Abdullah-Atif/gsm-gps-tracker/esp32_devkit/pcb/drc_report.txt

** Drc report for /mnt/attach/outputs/gsm_tracking/pcb/gsm_tracker.kicad_pcb **
** Created on 2026-10-05 23:04:57 **

** Found 51 DRC violations **
[silk_overlap]: Silkscreen overlap
    Rule: board setup constraints silk; Severity: warning
    @(9.6000 mm, 7.0000 mm): Reference 'C2'
    @(10.6000 mm, 8.0000 mm): PCB Text 'NET' on F.Silkscreen
[silk_overlap]: Silkscreen overlap
    Rule: board setup constraints silk; Severity: warning
    @(28.0000 mm, 37.4000 mm): Reference 'R2'
    @(28.6000 mm, 51.8000 mm): Line on F.Silkscreen
[silk_overlap]: Silkscreen overlap
    Rule: board setup constraints silk; Severity: warning
    @(25.0000 mm, 37.6000 mm): Reference 'C3'
    @(23.4600 mm, 36.2000 mm): Circle on F.Silkscreen
[silk_overlap]: Silkscreen overlap
    Rule: board setup constraints silk; Severity: warning
    @(5.2500 mm, 26.9000 mm): Reference 'C1'
    @(5.2500 mm, 31.5000 mm): Circle on F.Silkscreen
[silk_overlap]: Silkscreen overlap
    Rule: board setup constraints silk; Severity: warning
    @(5.2500 mm, 26.9000 mm): Reference 'C1'
    @(5.3700 mm, 27.4210 mm): Line on F.Silkscreen
[silk_overlap]: Silkscreen overlap
    Rule: board setup constraints silk; Severity: warning
    @(5.2500 mm, 26.9000 mm): Reference 'C1'
    @(5.4100 mm, 27.4230 mm): Line on F.Silkscreen
[silk_overlap]: Silkscreen overlap
    Rule: board setup constraints silk; Severity: warning
    @(5.2500 mm, 26.9000 mm): Reference 'C1'
    @(5.4500 mm, 27.4240 mm): Line on F.Silkscreen
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
[lib_footprint_issues]: The current configuration does not include the library ''.
    Local override; Severity: warning
    @(23.4600 mm, 32.8600 mm): Footprint R1
[lib_footprint_issues]: The current configuration does not include the library ''.
    Local override; Severity: warning
    @(58.3000 mm, 50.0000 mm): Footprint H1
[courtyards_overlap]: Courtyards overlap
    Rule: board setup constraints courtyard; Severity: error
    @(53.8600 mm, 10.0000 mm): Footprint J6
    @(56.4000 mm, 10.0000 mm): Footprint J7

** Found 0 unconnected pads **

** Found 0 Footprint errors **

** End of Report **
