Abdullah-Atif/gsm-gps-tracker/esp32c3_supermini/pcb/drc_report.txt

** Drc report for /mnt/attach/outputs/gsm_tracking/esp32c3_supermini/pcb/gsm_tracker_c3.kicad_pcb **
** Created on 2026-10-09 16:58:14 **

** Found 46 DRC violations **
[silk_overlap]: Silkscreen overlap
    Rule: board setup constraints silk; Severity: warning
    @(48.3400 mm, 9.0800 mm): PCB Text '3V3' on F.Silkscreen
    @(49.4100 mm, 5.2700 mm): Line on F.Silkscreen
[silk_overlap]: Silkscreen overlap
    Rule: board setup constraints silk; Severity: warning
    @(33.9000 mm, 1.0000 mm): Line on F.Silkscreen
    @(43.1200 mm, 1.3000 mm): PCB Text 'USB-C' on F.Silkscreen
[silk_overlap]: Silkscreen overlap
    Rule: board setup constraints silk; Severity: warning
    @(18.0000 mm, 5.5000 mm): PCB Text 'OFF     ON' on F.Silkscreen
    @(22.4100 mm, 5.2600 mm): Line on F.Silkscreen
[silk_overlap]: Silkscreen overlap
    Rule: board setup constraints silk; Severity: warning
    @(28.2500 mm, 0.9000 mm): PCB Text 'BAT' on F.Silkscreen
    @(32.0600 mm, 1.1400 mm): Line on F.Silkscreen
[silk_overlap]: Silkscreen overlap
    Rule: board setup constraints silk; Severity: warning
    @(28.2500 mm, 0.9000 mm): PCB Text 'BAT' on F.Silkscreen
    @(27.7500 mm, 1.1500 mm): Line on F.Silkscreen
[silk_overlap]: Silkscreen overlap
    Rule: board setup constraints silk; Severity: warning
    @(26.2000 mm, 6.2000 mm): PCB Text '+' on F.Silkscreen
    @(25.2000 mm, 6.3500 mm): Line on F.Silkscreen
[silk_overlap]: Silkscreen overlap
    Rule: board setup constraints silk; Severity: warning
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
    Local override; Severity: warning
    @(12.0000 mm, 34.1900 mm): Footprint J4
[lib_footprint_issues]: The current configuration does not include the library ''.
    Local override; Severity: warning
    @(3.0000 mm, 36.0000 mm): Footprint H1
[lib_footprint_issues]: The current configuration does not include the library ''.
    Local override; Severity: warning
    @(27.0000 mm, 3.6000 mm): Footprint J1
[lib_footprint_issues]: The current configuration does not include the library ''.
    Local override; Severity: warning
    @(34.5000 mm, 41.5000 mm): Footprint U3
[lib_footprint_issues]: The current configuration does not include the library ''.
    Local override; Severity: warning
    @(26.0000 mm, 13.3500 mm): Footprint R1
[lib_footprint_issues]: The current configuration does not include the library ''.
    Local override; Severity: warning
    @(16.0000 mm, 3.0000 mm): Footprint SW1
[lib_footprint_issues]: The current configuration does not include the library ''.
    Local override; Severity: warning
    @(35.5000 mm, 4.0000 mm): Footprint J6
[lib_footprint_issues]: The current configuration does not include the library ''.
    Local override; Severity: warning
    @(3.0000 mm, 48.5000 mm): Footprint H2
[lib_footprint_issues]: The current configuration does not include the library ''.
    Local override; Severity: warning
    @(49.5000 mm, 29.5000 mm): Footprint C3
[lib_footprint_issues]: The current configuration does not include the library ''.
    Local override; Severity: warning
    @(5.6000 mm, 17.1600 mm): Footprint C2
[lib_footprint_issues]: The current configuration does not include the library ''.
    Local override; Severity: warning
    @(50.7400 mm, 4.0000 mm): Footprint J5
[lib_footprint_issues]: The current configuration does not include the library ''.
    Local override; Severity: warning
    @(2.6000 mm, 19.7000 mm): Footprint J3
[lib_footprint_issues]: The current configuration does not include the library ''.
    Local override; Severity: warning
    @(20.3800 mm, 19.7000 mm): Footprint J8
[lib_footprint_issues]: The current configuration does not include the library ''.
    Local override; Severity: warning
    @(22.9200 mm, 19.7000 mm): Footprint J9
[silk_edge_clearance]: Silkscreen clipped by board edge
    Rule: board setup constraints silk; Severity: warning
    @(0.0000 mm, 0.0000 mm): Line on Edge.Cuts
    @(15.5000 mm, 0.0400 mm): Line on F.Silkscreen
[silk_edge_clearance]: Silkscreen clipped by board edge
    Rule: board setup constraints silk; Severity: warning
    @(0.0000 mm, 0.0000 mm): Line on Edge.Cuts
    @(16.0000 mm, 0.5400 mm): Line on F.Silkscreen
[silk_edge_clearance]: Silkscreen clipped by board edge
    Rule: board setup constraints silk; Severity: warning
    @(0.0000 mm, 0.0000 mm): Line on Edge.Cuts
    @(16.5000 mm, 0.0400 mm): Line on F.Silkscreen
[courtyards_overlap]: Courtyards overlap
    Rule: board setup constraints courtyard; Severity: error
    @(20.3800 mm, 19.7000 mm): Footprint J8
    @(22.9200 mm, 19.7000 mm): Footprint J9

** Found 0 unconnected pads **

** Found 0 Footprint errors **

** End of Report **
