Abdullah-Atif/gsm-gps-tracker/esp32_devkit/pcb/renders/back.png

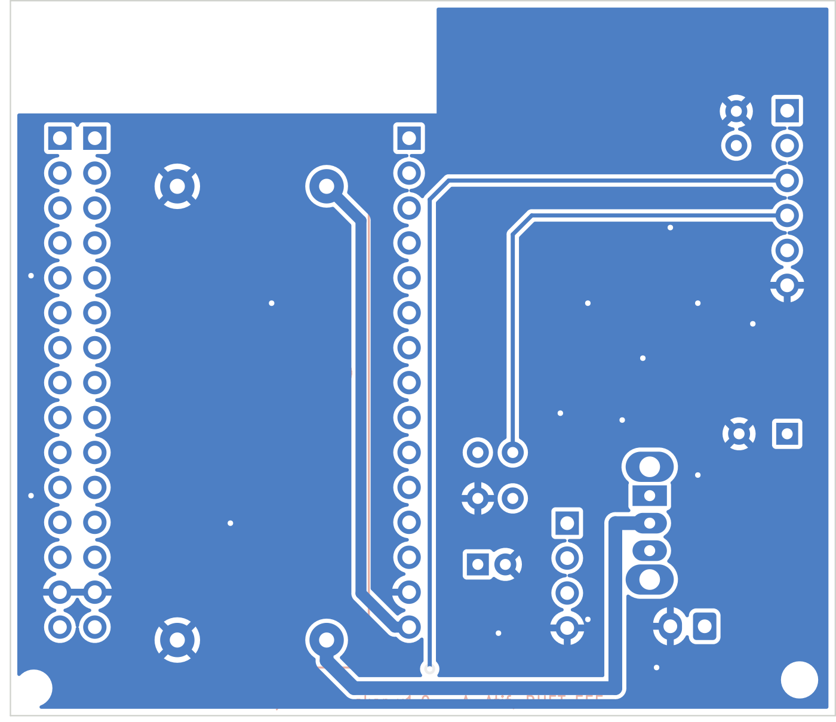
esp32_devkit/pcb/renders/back.png
