Abdullah-Atif/gsm-gps-tracker/esp32c3_supermini/pcb/renders/back.png

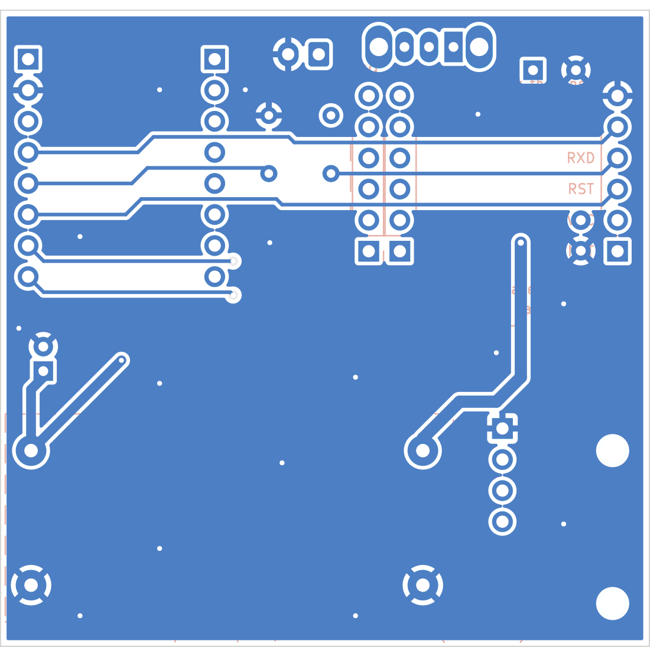
esp32c3_supermini/pcb/renders/back.png
