Abdullah-Atif/gsm-gps-tracker/esp32c3_supermini/pcb/renders/front.png

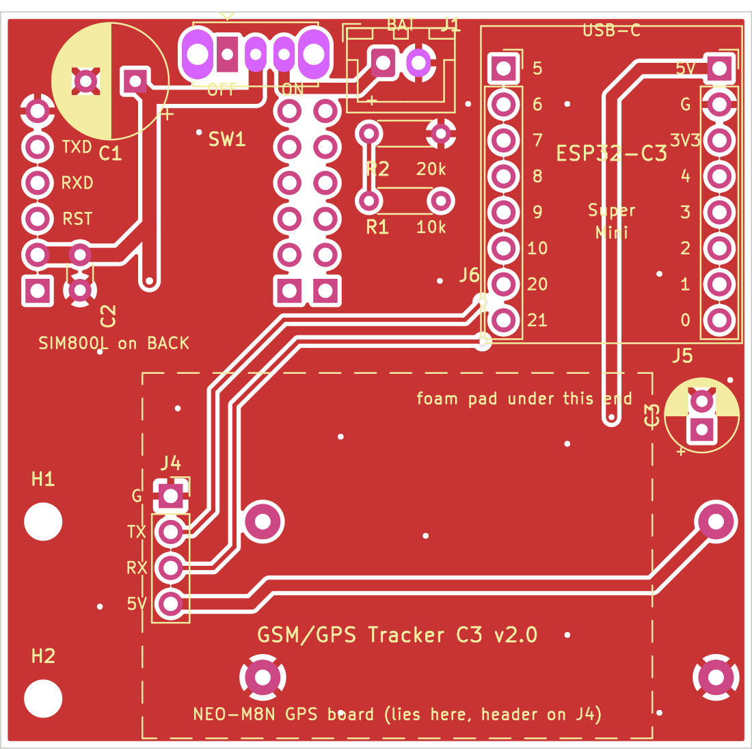
esp32c3_supermini/pcb/renders/front.png
