Abdullah-Atif/gsm-gps-tracker/esp32c3_supermini/pcb/gsm_tracker_c3.kicad_pcb

## KiCad design esp32c3_supermini/pcb/gsm_tracker_c3.kicad_pcb (2026-10-10)

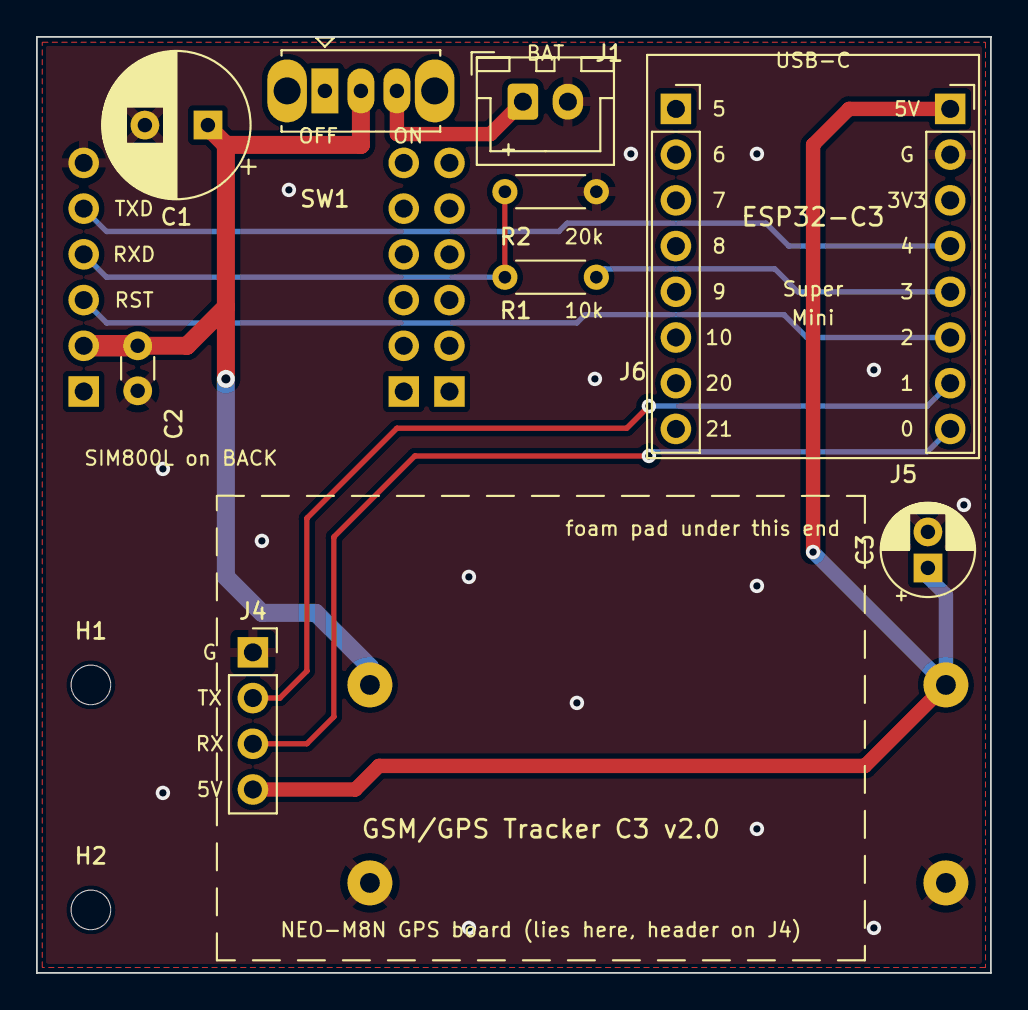
[picture p8: board gsm_tracker_c3.kicad_pcb from above]

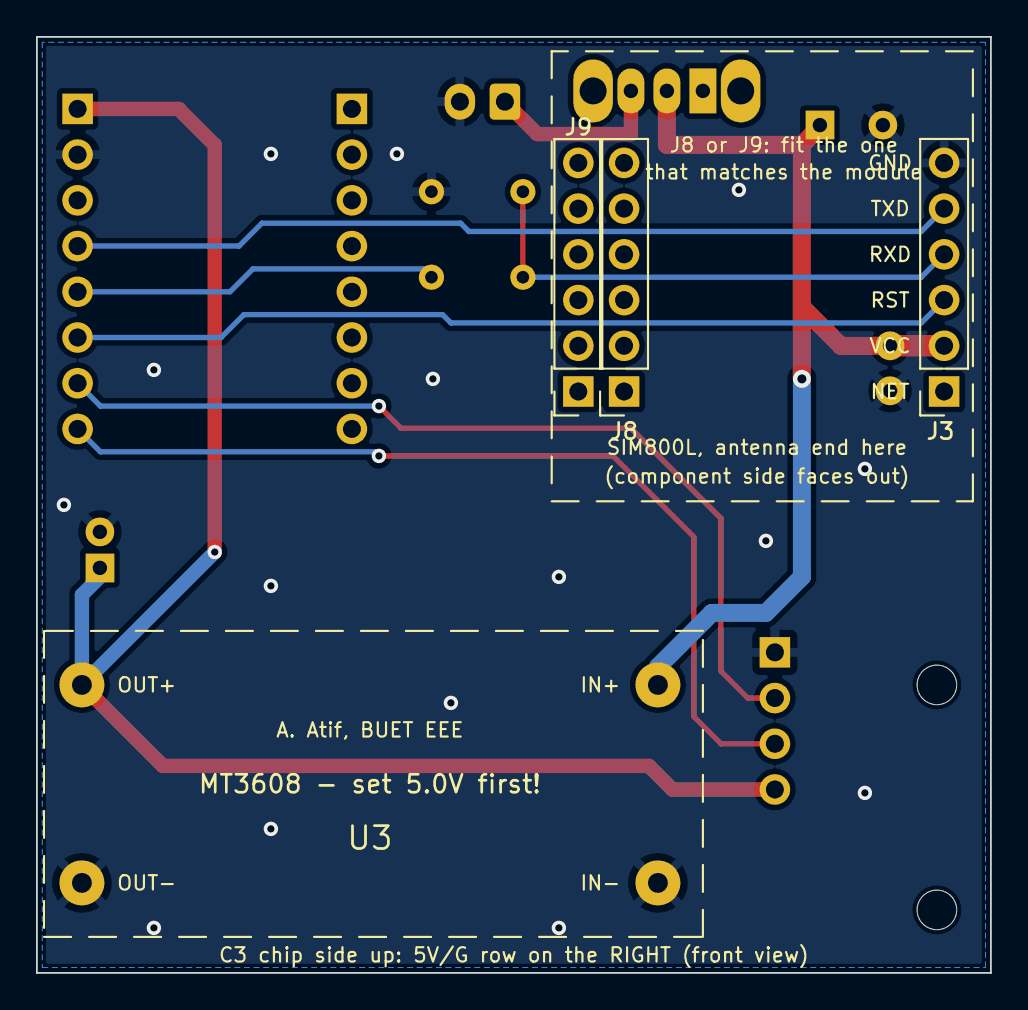
[picture p9: board gsm_tracker_c3.kicad_pcb from below]

Board: 2 copper layers, 53.0 x 52.0 mm, 16 parts (3 on the bottom side), 10 nets.

Parts:
C1: 1000uF_10V; CP_Radial_D8.0mm_P3.50mm
C2: 100nF; C_Disc_D3.0mm_W1.6mm_P2.50mm
C3: 100uF_10V; CP_Radial_D5.0mm_P2.00mm
H1, H2: M2; MountingHole_2.2mm_M2
J1: BATT_1S; JST_XH_B2B-XH-A_1x02_P2.50mm_Vertical
J3: SIM800L_IF; PinSocket_1x06_P2.54mm_Vertical
J4: GPS; PinSocket_1x04_P2.54mm_Vertical
J5: C3_POWER_ROW; PinSocket_1x08_P2.54mm_Vertical
J6: C3_GPIO5_21_ROW; PinSocket_1x08_P2.54mm_Vertical
J8: SIM800L_AUDIO_17.78; PinSocket_1x06_P2.54mm_Vertical
J9: SIM800L_AUDIO_20.32; PinSocket_1x06_P2.54mm_Vertical
R1: 10k; R_Axial_DIN0204_L3.6mm_D1.6mm_P5.08mm_Horizontal
R2: 20k; R_Axial_DIN0204_L3.6mm_D1.6mm_P5.08mm_Horizontal
SW1: PWR; SW_Slide_SPDT_Straight_CK_OS102011MS2Q
U3: MT3608_5V

Connections:
+5V: C3.1, J4.4, J5.1, U3.3
ESP_TX_SIM: J5.5, R1.2
GND: C1.2, C2.2, C3.2, J1.2, J3.6, J4.1, J5.2, R2.2, U3.2, U3.4
GPS_RX: J4.3, J5.8
GPS_TX: J4.2, J5.7
SIM_RST: J3.3, J5.6
SIM_RXD: J3.4, R1.1, R2.1
SIM_TXD: J3.5, J5.4
VBAT: C1.1, C2.1, J3.2, SW1.2, U3.1
VBAT_RAW: J1.1, SW1.3
