Abdullah-Atif/gsm-gps-tracker/esp32_devkit/pcb/gsm_tracker.kicad_pcb

## KiCad design esp32_devkit/pcb/gsm_tracker.kicad_pcb (2026-10-10)

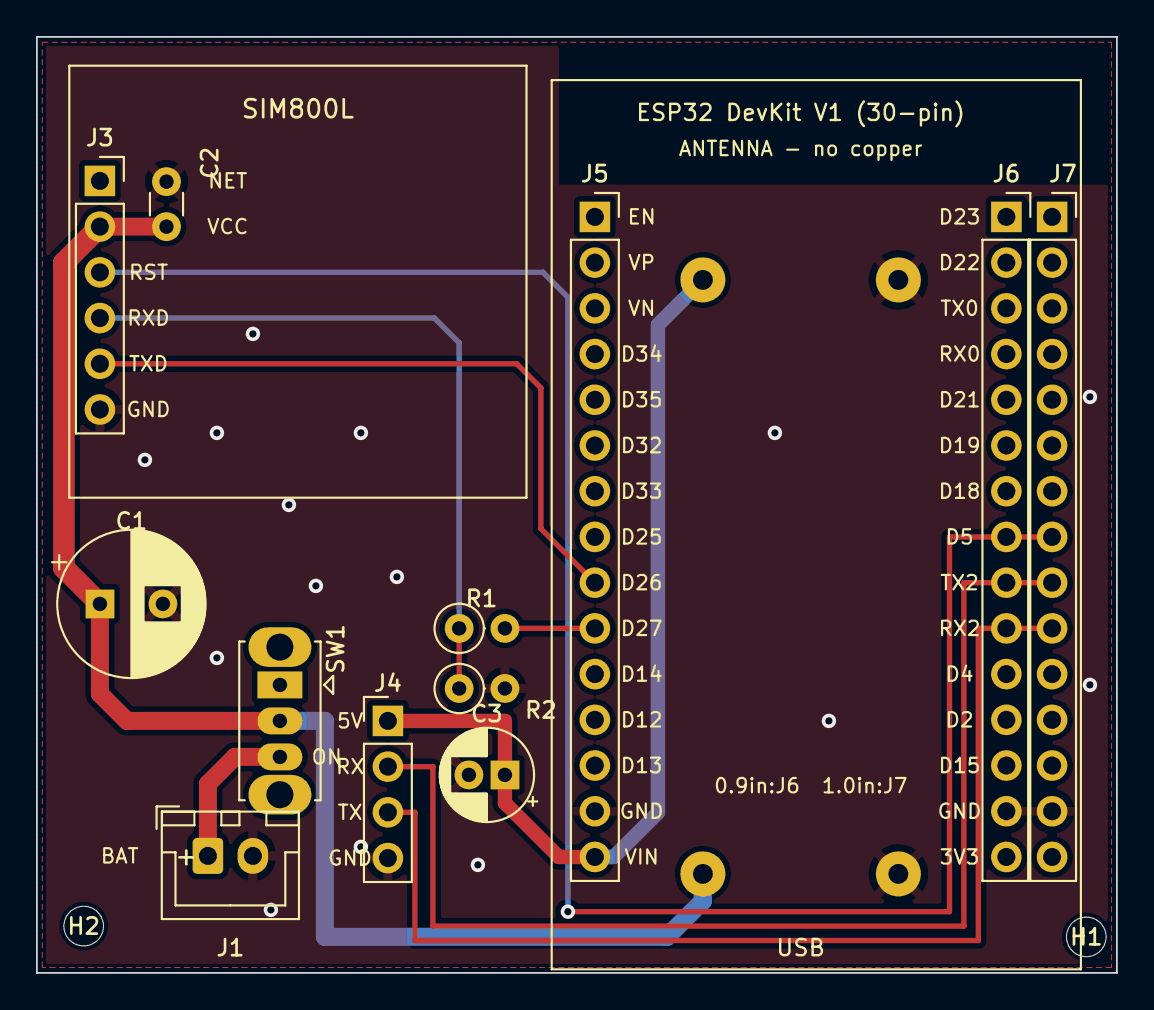
[picture p10: board gsm_tracker.kicad_pcb from above]

Board: 2 copper layers, 60.0 x 52.0 mm, 15 parts (0 on the bottom side), 10 nets.

Parts:
C1: 1000uF_10V; CP_Radial_D8.0mm_P3.50mm
C2: 100nF; C_Disc_D3.0mm_W1.6mm_P2.50mm
C3: 100uF_10V; CP_Radial_D5.0mm_P2.00mm
H1, H2: M2; MountingHole_2.2mm_M2
J1: BATT_1S; JST_XH_B2B-XH-A_1x02_P2.50mm_Vertical
J3: SIM800L; PinSocket_1x06_P2.54mm_Vertical
J4: GPS; PinHeader_1x04_P2.54mm_Vertical
J5: ESP32_L; PinSocket_1x15_P2.54mm_Vertical
J6: ESP32_R_0.9in; PinSocket_1x15_P2.54mm_Vertical
J7: ESP32_R_1.0in_ALT; PinSocket_1x15_P2.54mm_Vertical
R1: 10k; R_Axial_DIN0207_L6.3mm_D2.5mm_P2.54mm_Vertical
R2: 20k; R_Axial_DIN0207_L6.3mm_D2.5mm_P2.54mm_Vertical
SW1: PWR; SW_Slide_SPDT_Straight_CK_OS102011MS2Q
U3: MT3608_5V

Connections:
+5V: C3.1, J4.1, J5.15, U3.3
ESP_IO27: J5.10, R1.2
GND: C1.2, C2.2, C3.2, J1.2, J3.6, J4.4, J5.14, J6.14, J7.14, R2.2, U3.2, U3.4
GPS_RX: J4.2, J6.9, J7.9
GPS_TX: J4.3, J6.10, J7.10
SIM_RST: J3.3, J6.8, J7.8
SIM_RXD: J3.4, R1.1, R2.1
SIM_TXD: J3.5, J5.9
VBAT: C1.1, C2.1, J3.2, SW1.2, U3.1
VBAT_RAW: J1.1, SW1.3
