Abdullah-Atif/gsm-gps-tracker/(commit log)

2026-10-10 Add firmware, KiCad PCBs, wiring diagram and web map
    ESP32 DevKit and ESP32-C3 Super Mini firmware, carrier PCBs (KiCad + Gerbers), wiring diagram, pinout and the live map page.
    [BOM.csv, gsm_tracker.kicad_pcb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]
2026-10-10 Add README for GSM/GPS Live Vehicle Tracker
    Added detailed project documentation for the GSM/GPS Live Vehicle Tracker, including hardware specifications, wiring diagrams, and usage instructions.
2026-10-10 Add KiCad and Arduino files to .gitignore
